gbhug5a/Mailbox-Notifier/MailboxNotifier.jpg

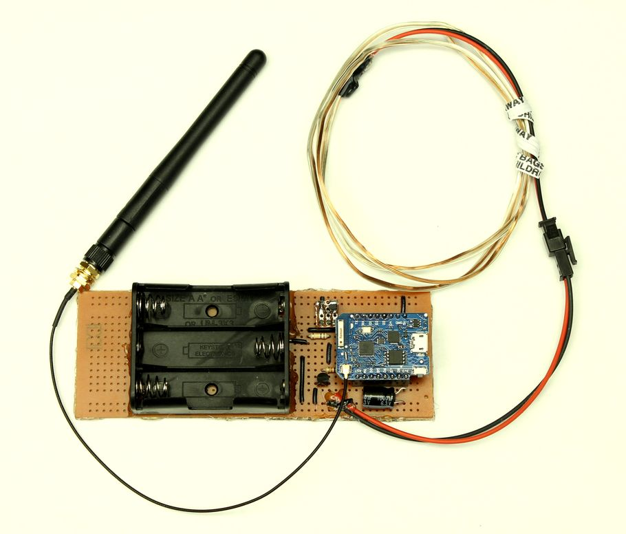
MailboxNotifier.jpg
