gbhug5a/Mailbox-Notifier/Links.pdf

Lolin/Wemos (clone) D1 Mini Pro with headers, pigtail and antenna (RP-SMA) https://www.banggood.com/Geekcreit-D1-Mini-Pro-16-Module-ESP8266-Series-WiFi-Wireless-Antenna-p-1144951.html

### 3 x AA battery holder with PC pin connectors

https://www.digikey.com/product-detail/en/keystone-electronics/2464/36-2464-ND/303813

IRLML6401 P-channel mosfet https://www.digikey.com/product-detail/en/infineontechnologies/IRLML6401TRPBF/IRLML6401PBFCT-ND/812509

SOT23-3 to SIP adapter
https://www.ebay.com/itm/10-Pcs-Double-Side-SMD-SOT23-3-To-DIP-SIP3-Adapter-PCB-Board-DIY-Converter/122798527441

Panasonic FR electrolytic capacitor 1000µF, 6.3V https://www.digikey.com/product-detail/en/panasonic-electronic-components/EEU-FR0J102/P124215-ND/9921020

DIY solderable PC boards in breadboard format https://www.ebay.com/itm/10x-4-8x13-3cm-DIY-Prototype-Paper-PCB-Universal-Experiment-Matrix-Circuit-Board/113201209585

Energizer "Ultimate Lithium" lithium iron disulfide AA batteries - 4 pack https://www.amazon.com/Energizer-Ultimate-Lithium-Batteries-Pack/dp/B0023T8OUY/(may also be available locally)

Magnetic reed switch
https://www.amazon.com/Directed-Electronics-8601-Magnetic-Switch/dp/B0009SUF08

Alternate Microswitch that might work https://www.digikey.com/product-detail/en/omron-electronics-inc-emc-div/SS-5-F-2D/Z5069-ND/5236944
