gbhug5a/Mailbox-Notifier/MailboxNotifierSchematic.jpg

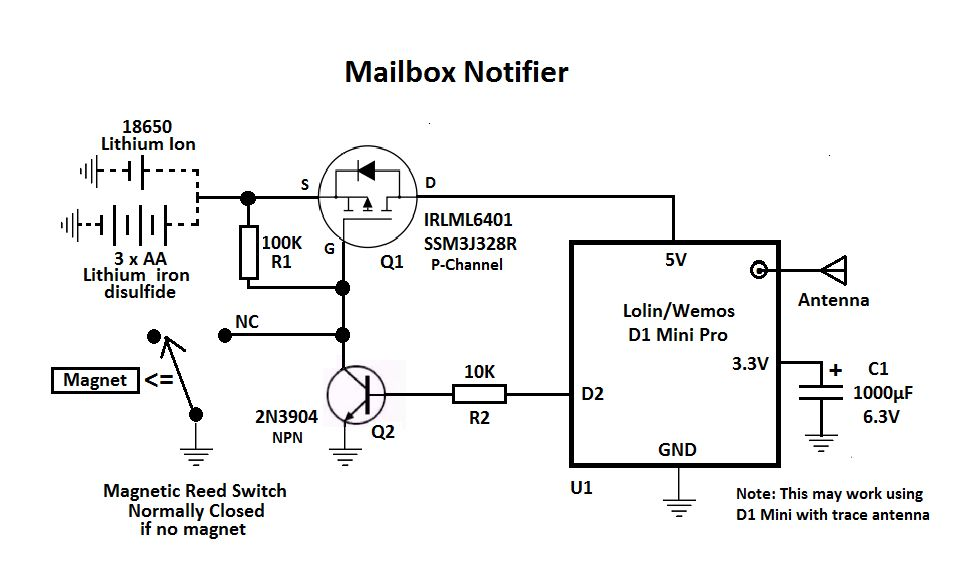
MailboxNotifierSchematic.jpg
