gbhug5a/Mailbox-Notifier/Update-2025/Mailbox Notifier Circuit v2.png

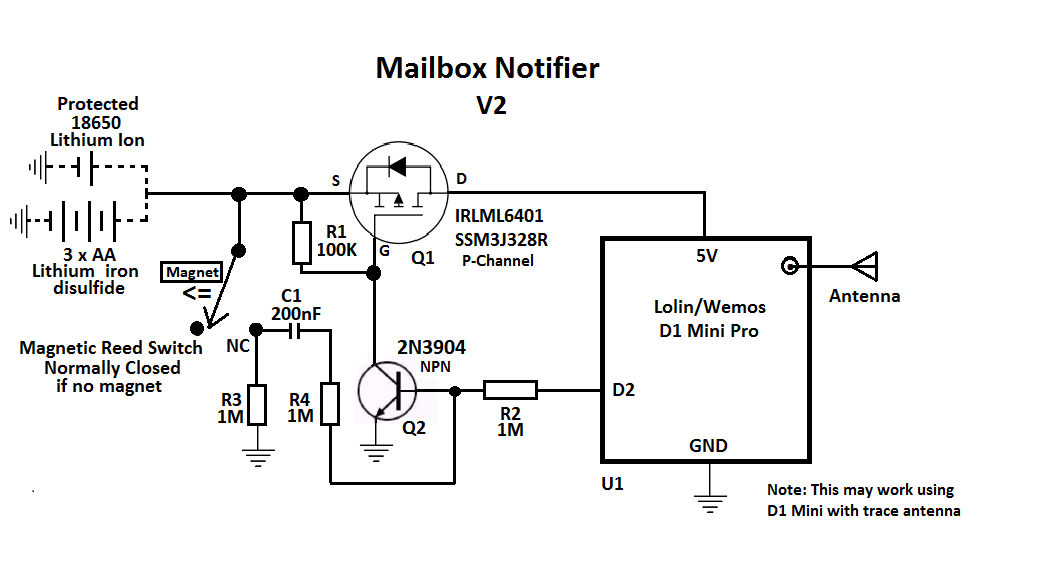
Update-2025/Mailbox Notifier Circuit v2.png
